minisystem/STM32-Nucleo-DAC-Shield/STM32 Nucleo Arduino Shield.kicad_pcb

## KiCad design STM32 Nucleo Arduino Shield.kicad_pcb (2017-02-07)

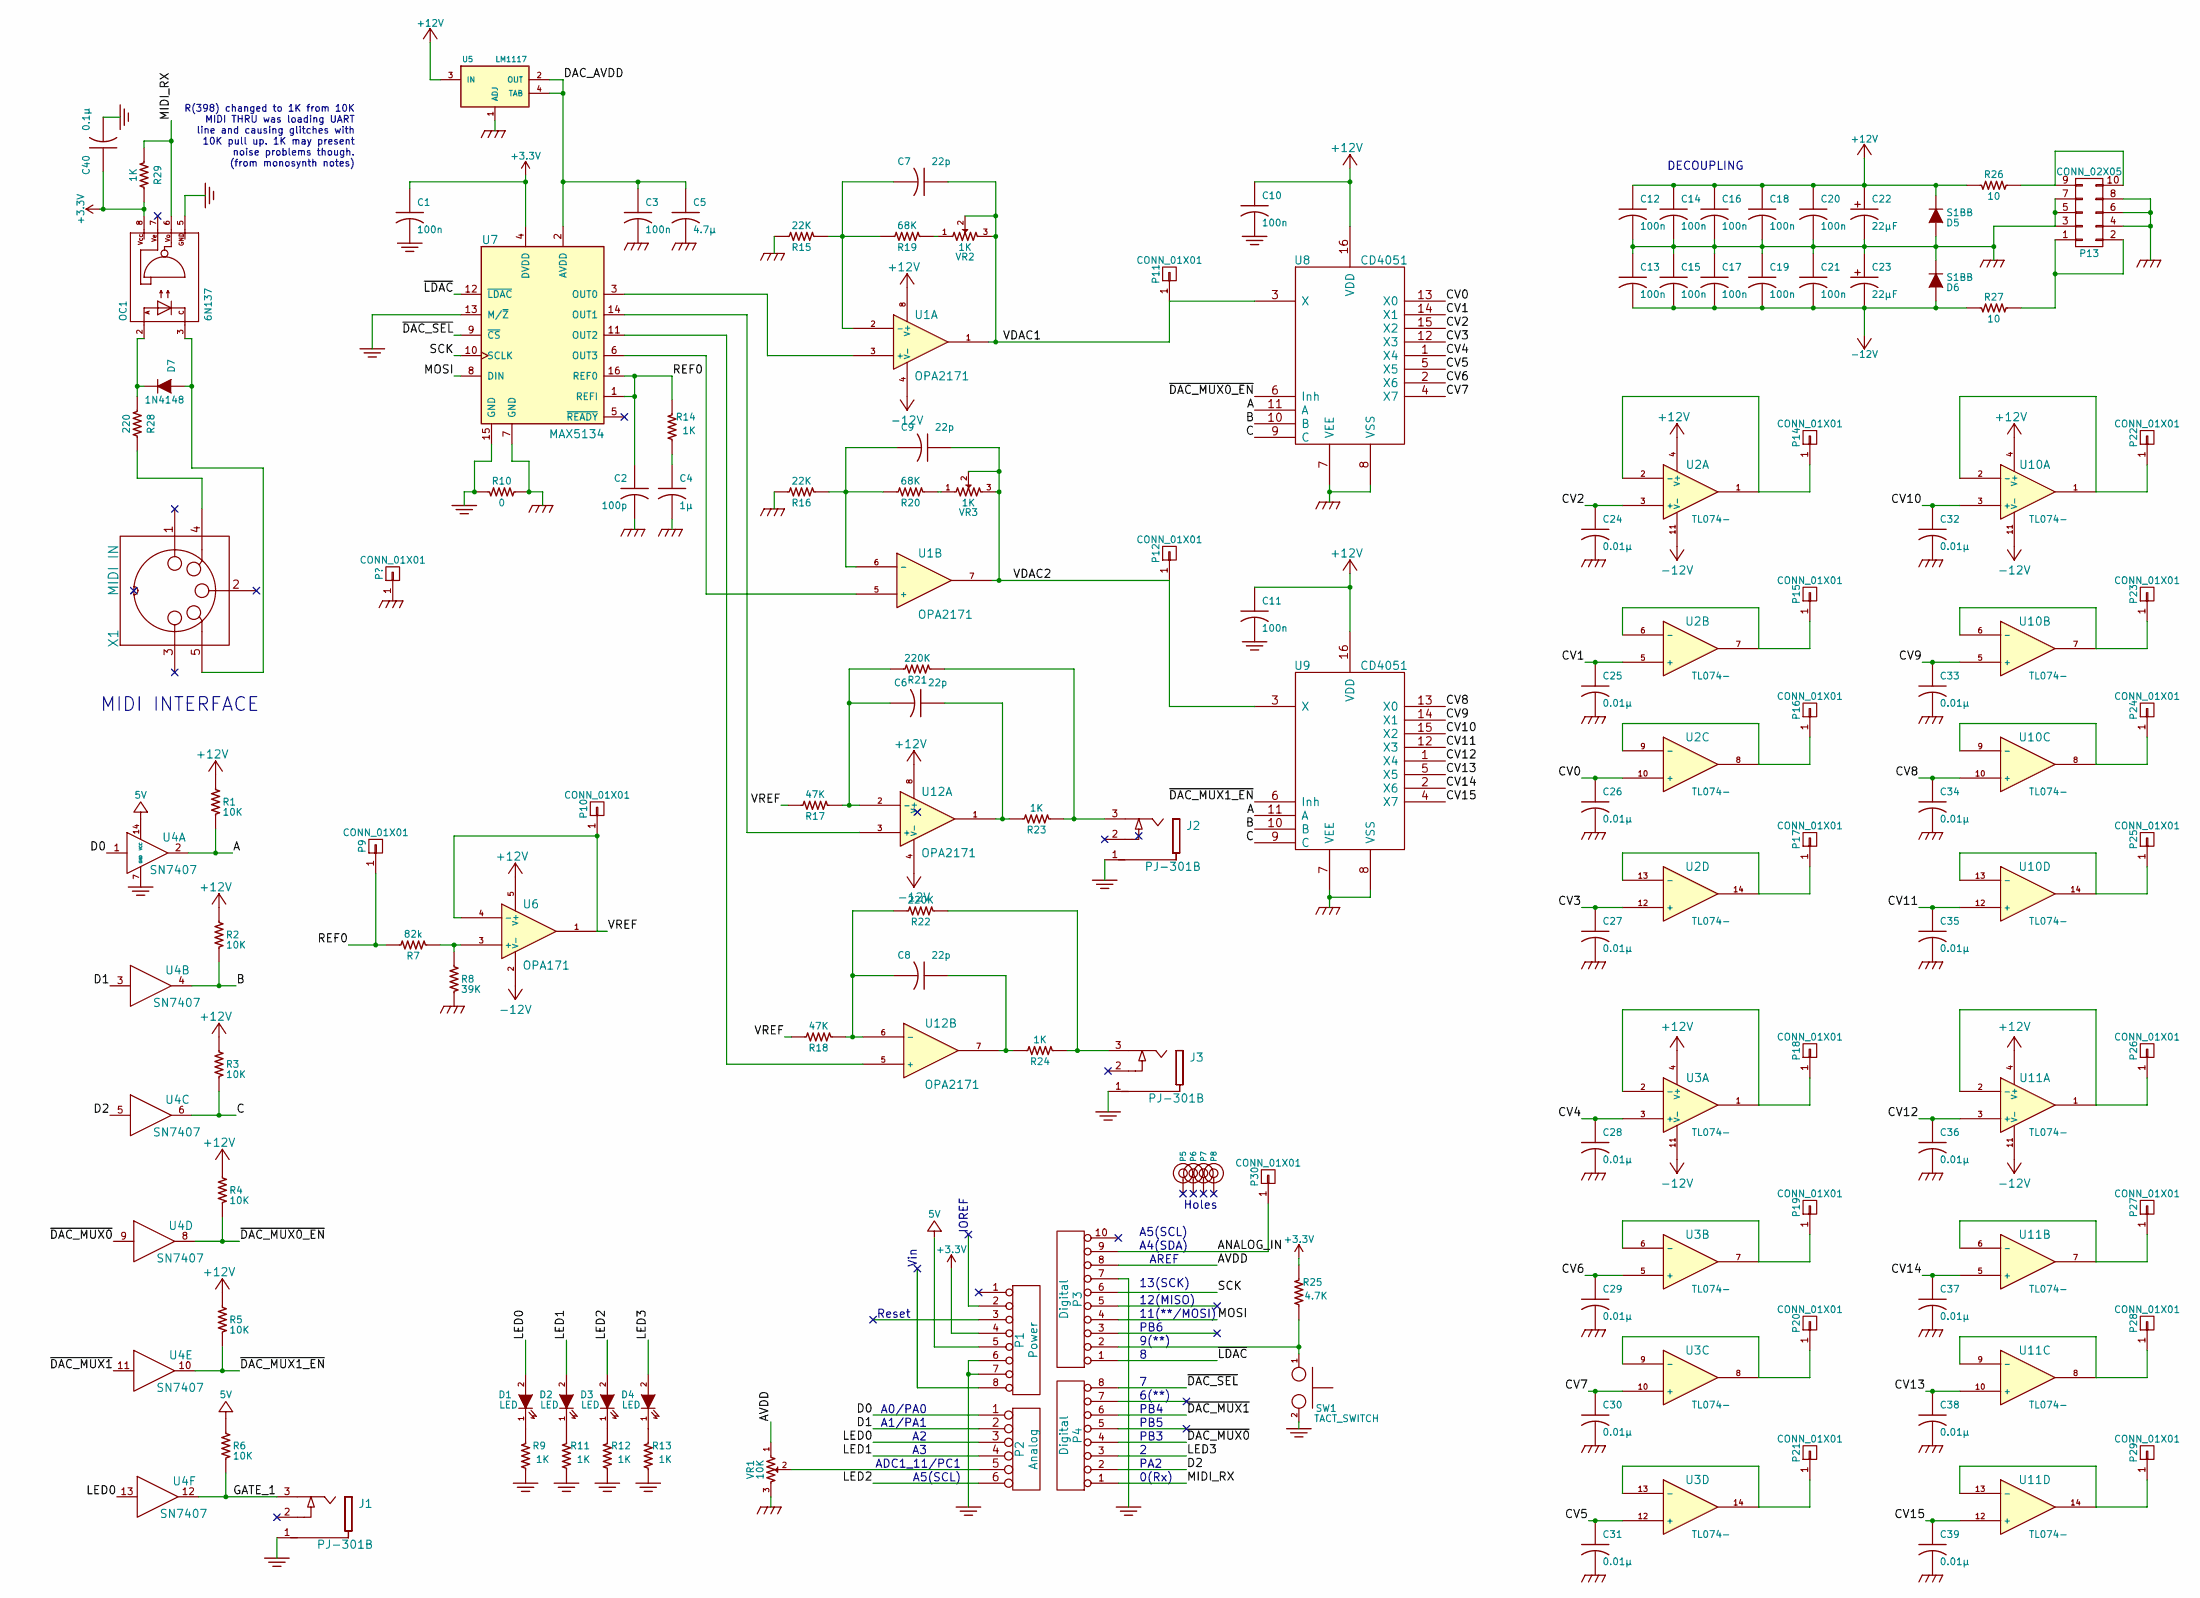
[picture p1: schematic STM32 Nucleo Arduino Shield.sch]

Parts:
C1, C3, C10, C11, C12, C13, C14, C15, C16, C17, C18, C19, C20, C21: 100n; SM0603-C-JRL
C2: 100p; SM0603-C-JRL
C4: 1μ; SM0603-C-JRL
C5: 4.7μ; SM0805-HAND
C6, C7, C8, C9: 22p; SM0603-C-JRL
C22, C23: 22μF; jrl_c_elec_5x5.3; Part Number UWJ1E100MCL1GB
C24, C25, C26, C27, C28, C29, C30, C31, C32, C33, C34, C35, C36, C37, C38, C39: 0.01µ; SM0603-C-JRL
C40: 0.1µ; SM0603-C-JRL
D1, D2, D3, D4: LED; LED-0805-JRL
D5, D6: S1BB; SMB-1C2A
D7: 1N4148; SOD323-C1A2
J1, J2, J3: PJ-301B; PJ-301B-JACK-SLOTS
OC1: 6N137; 8-SMD
P1: Power; Socket_Strip_Arduino_1x08
P2: Analog; Socket_Strip_Arduino_1x06
P3: Digital; Socket_Strip_Arduino_1x10
P4: Digital; Socket_Strip_Arduino_1x08
P5, P6, P7, P8: CONN_1; Arduino_1pin
P9, P10, P11, P12, P14, P15, P16, P17, P18, P19, P20, P21, P22, P23, P24, P25, P26, P27, P28, P29, P30: CONN_01X01; TEST_POINT_SMALL
P13: CONN_02X05; Pin_Header_Straight_2x05_Pitch2.54mm
R1, R2, R3, R4, R5, R6: 10K; SM0603-R-JRL
R7: 82k; SM0603-R-JRL
R8: 39K; SM0603-R-JRL
R9, R11, R12, R13, R14, R23, R24, R29: 1K; SM0603-R-JRL
R10: 0; SM0603-R-JRL
R15, R16: 22K; SM0603-R-JRL
R17, R18: 47K; SM0603-R-JRL
R19, R20: 68K; SM0603-R-JRL
R21, R22: 220K; SM0603-R-JRL
R25: 4.7K; SM0603-R-JRL
R26, R27: 10; SM0805-HAND
R28: 220; SM0603-R-JRL
SW1: TACT_SWITCH; B3F-1050-OMRON
U1, U12: OPA2171; TSSOP-8_3x3mm_Pitch0.65mm
U2, U3, U10, U11: TL074-; TSSOP-14_4.4x5mm_Pitch0.65mm
U4: SN7407; SOIC-14_3.9x8.7mm_Pitch1.27mm
U5: LM1117; SOT-223
U6: OPA171; SOT-23-5
U7: MAX5134; TSSOP-16_4.4x5mm_Pitch0.65mm
U8, U9: CD4051; TSSOP-16_4.4x5mm_Pitch0.65mm_jrl
VR1: 10K; R0904N-SONG-HUEI
VR2, VR3: 1K; TC33X-2
X1: MIDI IN; SD-50BV-5DIN

Connections:
+3V3: C1.1, C40.1, OC1.8, P1.4, R25.1, R29.2, U7.4 (DVDD)
+5V: P1.5, R6.2, U4.14 (VCC)
+12V: C10.1, C11.1, C12.1, C14.1, C16.1, C18.1, C20.1, C22.1 (+), D5.1 (K), R1.2, R2.2, R3.2, R4.2, R5.2, R26.1, U1.8 (V+), U2.4 (V+), U3.4 (V+), U5.3 (IN), U6.5 (V+), U8.16 (VDD), U9.16 (VDD), U10.4 (V+), U11.4 (V+), U12.8 (V+)
-12V: C13.2, C15.2, C17.2, C19.2, C21.2, C23.2 (-), D6.2 (A), R27.1, U1.4 (V-), U2.11 (V-), U3.11 (V-), U6.2 (V-), U10.11 (V-), U11.11 (V-), U12.4 (V-)
/A: R1.1, U4.2, U8.11 (A), U9.11 (A)
/ANALOG_IN: P3.9, P30.1
/AVDD: P3.8, VR1.1
/B: R2.1, U4.4, U8.10 (B), U9.10 (B)
/C: R3.1, U4.6, U8.9 (C), U9.9 (C)
/CV0: C26.1, U2.10 (+), U8.13 (X0)
/CV1: C25.1, U2.5 (+), U8.14 (X1)
/CV2: C24.1, U2.3 (+), U8.15 (X2)
/CV3: C27.1, U2.12 (+), U8.12 (X3)
/CV4: C28.1, U3.3 (+), U8.1 (X4)
/CV5: C31.1, U3.12 (+), U8.5 (X5)
/CV6: C29.1, U3.5 (+), U8.2 (X6)
/CV7: C30.1, U3.10 (+), U8.4 (X7)
/CV8: C34.1, U9.13 (X0), U10.10 (+)
/CV9: C33.1, U9.14 (X1), U10.5 (+)
/CV10: C32.1, U9.15 (X2), U10.3 (+)
/CV11: C35.1, U9.12 (X3), U10.12 (+)
/CV12: C36.1, U9.1 (X4), U11.3 (+)
/CV13: C38.1, U9.5 (X5), U11.10 (+)
/CV14: C37.1, U9.2 (X6), U11.5 (+)
/CV15: C39.1, U9.4 (X7), U11.12 (+)
/D0: P2.1, U4.1
/D1: P2.2, U4.3
/D2: P4.2, U4.5
/DAC_AVDD: C3.1, C5.1, U5.2 (OUT), U5.4 (TAB), U7.2 (AVDD)
/GATE_1: J1.3, R6.1, U4.12
/LED0: D1.2 (A), P2.3, U4.13
/LED1: D2.2 (A), P2.4
/LED2: D3.2 (A), P2.6
/LED3: D4.2 (A), P4.3
/MIDI_RX: OC1.6, P4.1, R29.1
/MOSI: P3.4, U7.8 (DIN)
/REF0: C2.1, P9.1, R7.2, R14.1, U7.1 (REFI), U7.16 (REF0)
/SCK: P3.6, U7.10 (SCLK)
/VDAC1: C7.1, P11.1, U1.1, U8.3 (X), VR2.2, VR2.3
/VDAC2: C9.1, P12.1, U1.7, U9.3 (X), VR3.2, VR3.3
/VREF: P10.1, R17.2, R18.2, U6.1, U6.4 (-)
/~DAC_MUX0: P4.4, U4.9
/~DAC_MUX0_EN: R4.1, U4.8, U8.6 (Inh)
/~DAC_MUX1: P4.6, U4.11
/~DAC_MUX1_EN: R5.1, U4.10, U9.6 (Inh)
/~DAC_SEL: P4.8, U7.9 (~CS~)
/~LDAC: P3.1, U7.12 (~LDAC~)
unnamed: C4.1, R14.2
unnamed: C6.1, R23.2, U12.1
unnamed: C6.2, R17.1, R21.2, U12.2 (-)
unnamed: C7.2, R15.1, R19.2, U1.2 (-)
unnamed: C8.1, R24.2, U12.7
unnamed: C8.2, R18.1, R22.2, U12.6 (-)
unnamed: C9.2, R16.1, R20.2, U1.6 (-)
unnamed: D1.1 (K), R9.1
unnamed: D2.1 (K), R11.1
unnamed: D3.1 (K), R12.1
unnamed: D4.1 (K), R13.1
unnamed: D7.1 (K), OC1.2, R28.1
unnamed: D7.2 (A), OC1.3, X1.5
unnamed: J2.3, R21.1, R23.1
unnamed: J3.3, R22.1, R24.1
unnamed: P2.5, VR1.2
unnamed: P3.2, R25.2, SW1.1
unnamed: P13.1, P13.2, R27.2
unnamed: P13.9, P13.10, R26.2
unnamed: P14.1, U2.1, U2.2 (-)
unnamed: P15.1, U2.6 (-), U2.7
unnamed: P16.1, U2.8, U2.9 (-)
unnamed: P17.1, U2.13 (-), U2.14
unnamed: P18.1, U3.1, U3.2 (-)
unnamed: P19.1, U3.6 (-), U3.7
unnamed: P20.1, U3.8, U3.9 (-)
unnamed: P21.1, U3.13 (-), U3.14
unnamed: P22.1, U10.1, U10.2 (-)
unnamed: P23.1, U10.6 (-), U10.7
unnamed: P24.1, U10.8, U10.9 (-)
unnamed: P25.1, U10.13 (-), U10.14
unnamed: P26.1, U11.1, U11.2 (-)
unnamed: P27.1, U11.6 (-), U11.7
unnamed: P28.1, U11.8, U11.9 (-)
unnamed: P29.1, U11.13 (-), U11.14
unnamed: R7.1, R8.2, U6.3 (+)
unnamed: R19.1, VR2.1
unnamed: R20.1, VR3.1
unnamed: R28.2, X1.4
unnamed: U1.3 (+), U7.3 (OUT0)
unnamed: U1.5 (+), U7.6 (OUT3)
unnamed: U7.14 (OUT1), U12.3 (+)
unnamed: U7.11 (OUT2), U12.5 (+)

Notes on the sheet:
Reset
Vin
IOREF
A0/PA0
A1/PA1
ADC1_11/PC1
A5(SCL)
0(Rx)
PA2
PB3
PB5
PB4
6(**)
9(**)
PB6
AREF
A4(SDA)
Holes
13(SCK)
12(MISO)
11(**/MOSI)
MIDI INTERFACE
R(398) changed to 1K from 10K MIDI THRU was loading UART line and causing glitches with 10K pull up. 1K may present noise problems though. (from monosynth notes)
DECOUPLING

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
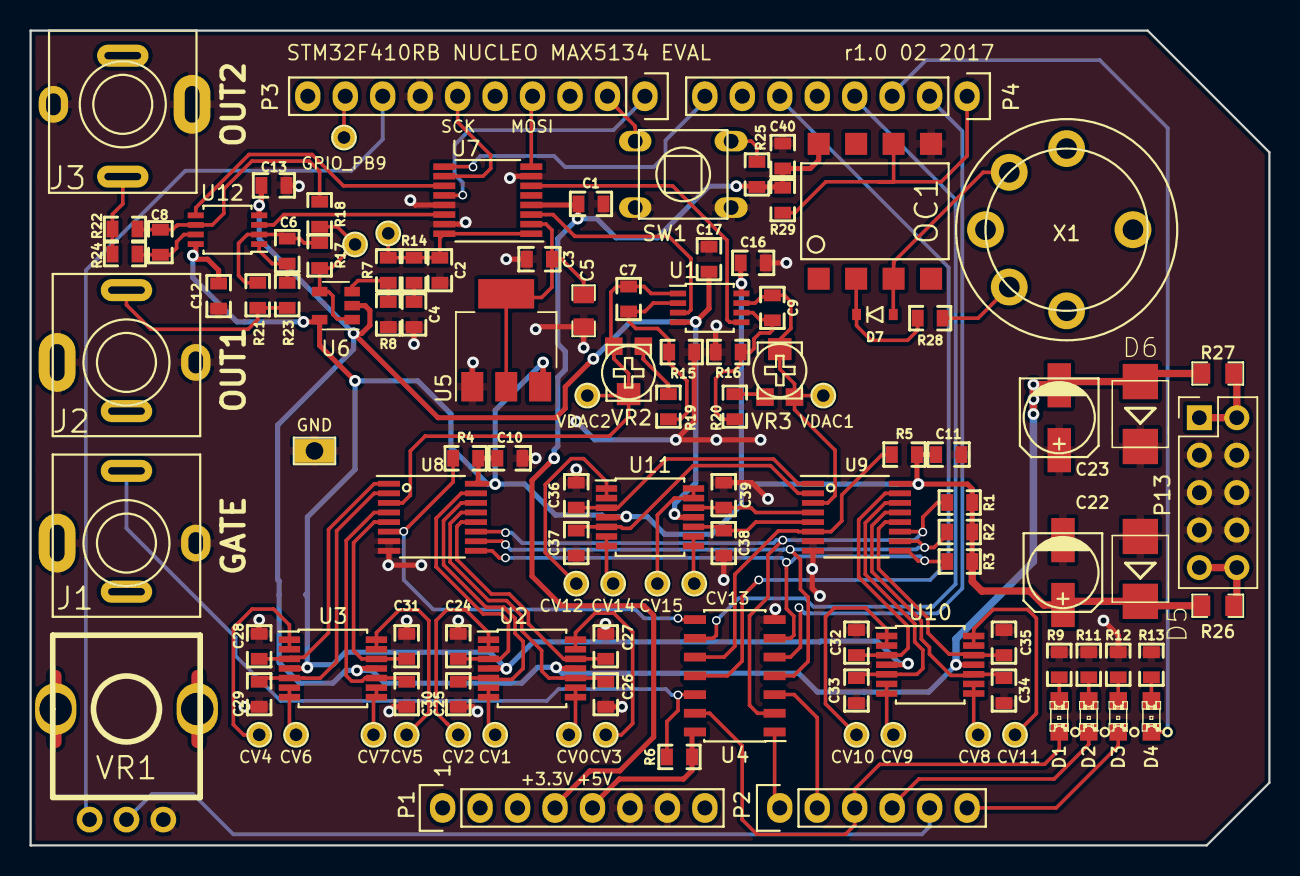
[picture p2: board STM32 Nucleo Arduino Shield.kicad_pcb from above]

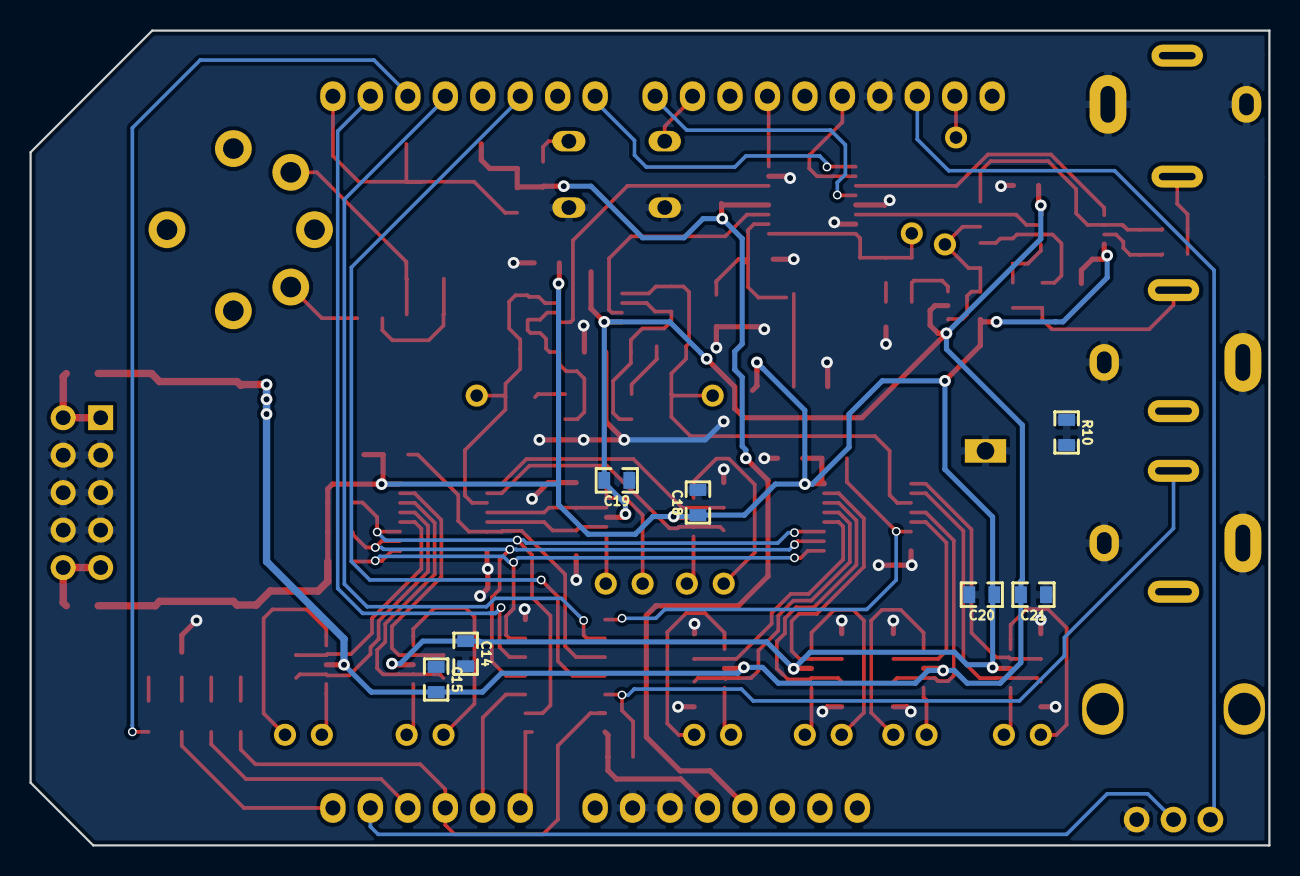
[picture p3: board STM32 Nucleo Arduino Shield.kicad_pcb from below]

Board: 2 copper layers, 84.0 x 55.2 mm, 124 parts (7 on the bottom side), 91 nets.

Other parts of the board:
P31: CONN_01X01; TEST_POINT_LOOP_4592
