minisystem/STM32-Nucleo-DAC-Shield/(commit log)

2017-01-30 adding a bunch of crap. as usual, evaluation board is getting out of hand
    [STM32 Nucleo Arduino Shield.sch]
2017-01-31 footprints assigned, netlist generated, layout started
    [STM32 Nucleo Arduino Shield.kicad_pcb, STM32 Nucleo Arduino Shield.sch]
2017-02-01 routing routing routing
    [STM32 Nucleo Arduino Shield.kicad_pcb]
2017-02-02 more tedious routing
    [STM32 Nucleo Arduino Shield.kicad_pcb, STM32 Nucleo Arduino Shield.sch]
2017-02-03 mostly routed S&H circuits
    [STM32 Nucleo Arduino Shield.kicad_pcb, STM32 Nucleo Arduino Shield.sch]
2017-02-03 everything placed and routing. stitching ground
    [STM32 Nucleo Arduino Shield.kicad_pcb, STM32 Nucleo Arduino Shield.sch]
2017-02-03 routed. weird Socket_Arduino_Uno library glitch required reinstalling footprint library from Arduino tempalte folder
    [STM32 Nucleo Arduino Shield.kicad_pcb, STM32 Nucleo Arduino Shield.sch]
2017-02-03 ready for checking
    [STM32 Nucleo Arduino Shield.kicad_pcb, STM32 Nucleo Arduino Shield.sch]
2017-02-04 finished adding 3D models
    [STM32 Nucleo Arduino Shield.kicad_pcb, STM32 Nucleo Arduino Shield.sch]
2017-02-07 checked shield footprint and ordered PCBs
    [STM32 Nucleo Arduino Shield.kicad_pcb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]
